rohaanbrar-stack/stm32-hvac-ecosystem/(commit log)

2026-06-23 BMP280 Driver with I2C, USART and Clock + README
2026-06-23 Servo PWM Driver and Integrated with BMP280
2026-06-25 TX Side nRF24 Driver
2026-06-26 Control Node + nRF24 SPI Comms Verified
2026-06-30 nRF24 RX Driver + 2 Node Link Confirmed
2026-07-07 nRF24 Driver Debugs + Testing
2026-07-15 Retire nRF24 Wireless, Using Wired UART Link
2026-07-31 Timer Integration + Cleanup
2026-08-19 Copied SD Reader Files From IMU Logger
2026-08-20 PIR Sensor Driver + Tested & SD Reader Tested
2026-08-21 Wiring Diagram
